furioustank986/huskey60/README.md

# huskey60
Barebones hotswap 60% pcb with USB-C.
KiCad libraries can get messed up depending on what system you're on. Locate the libraries accordingly.
