furioustank986/huskey60/pcb/pcb.kicad_pcb

## KiCad design pcb/pcb.kicad_pcb (2021-10-20)

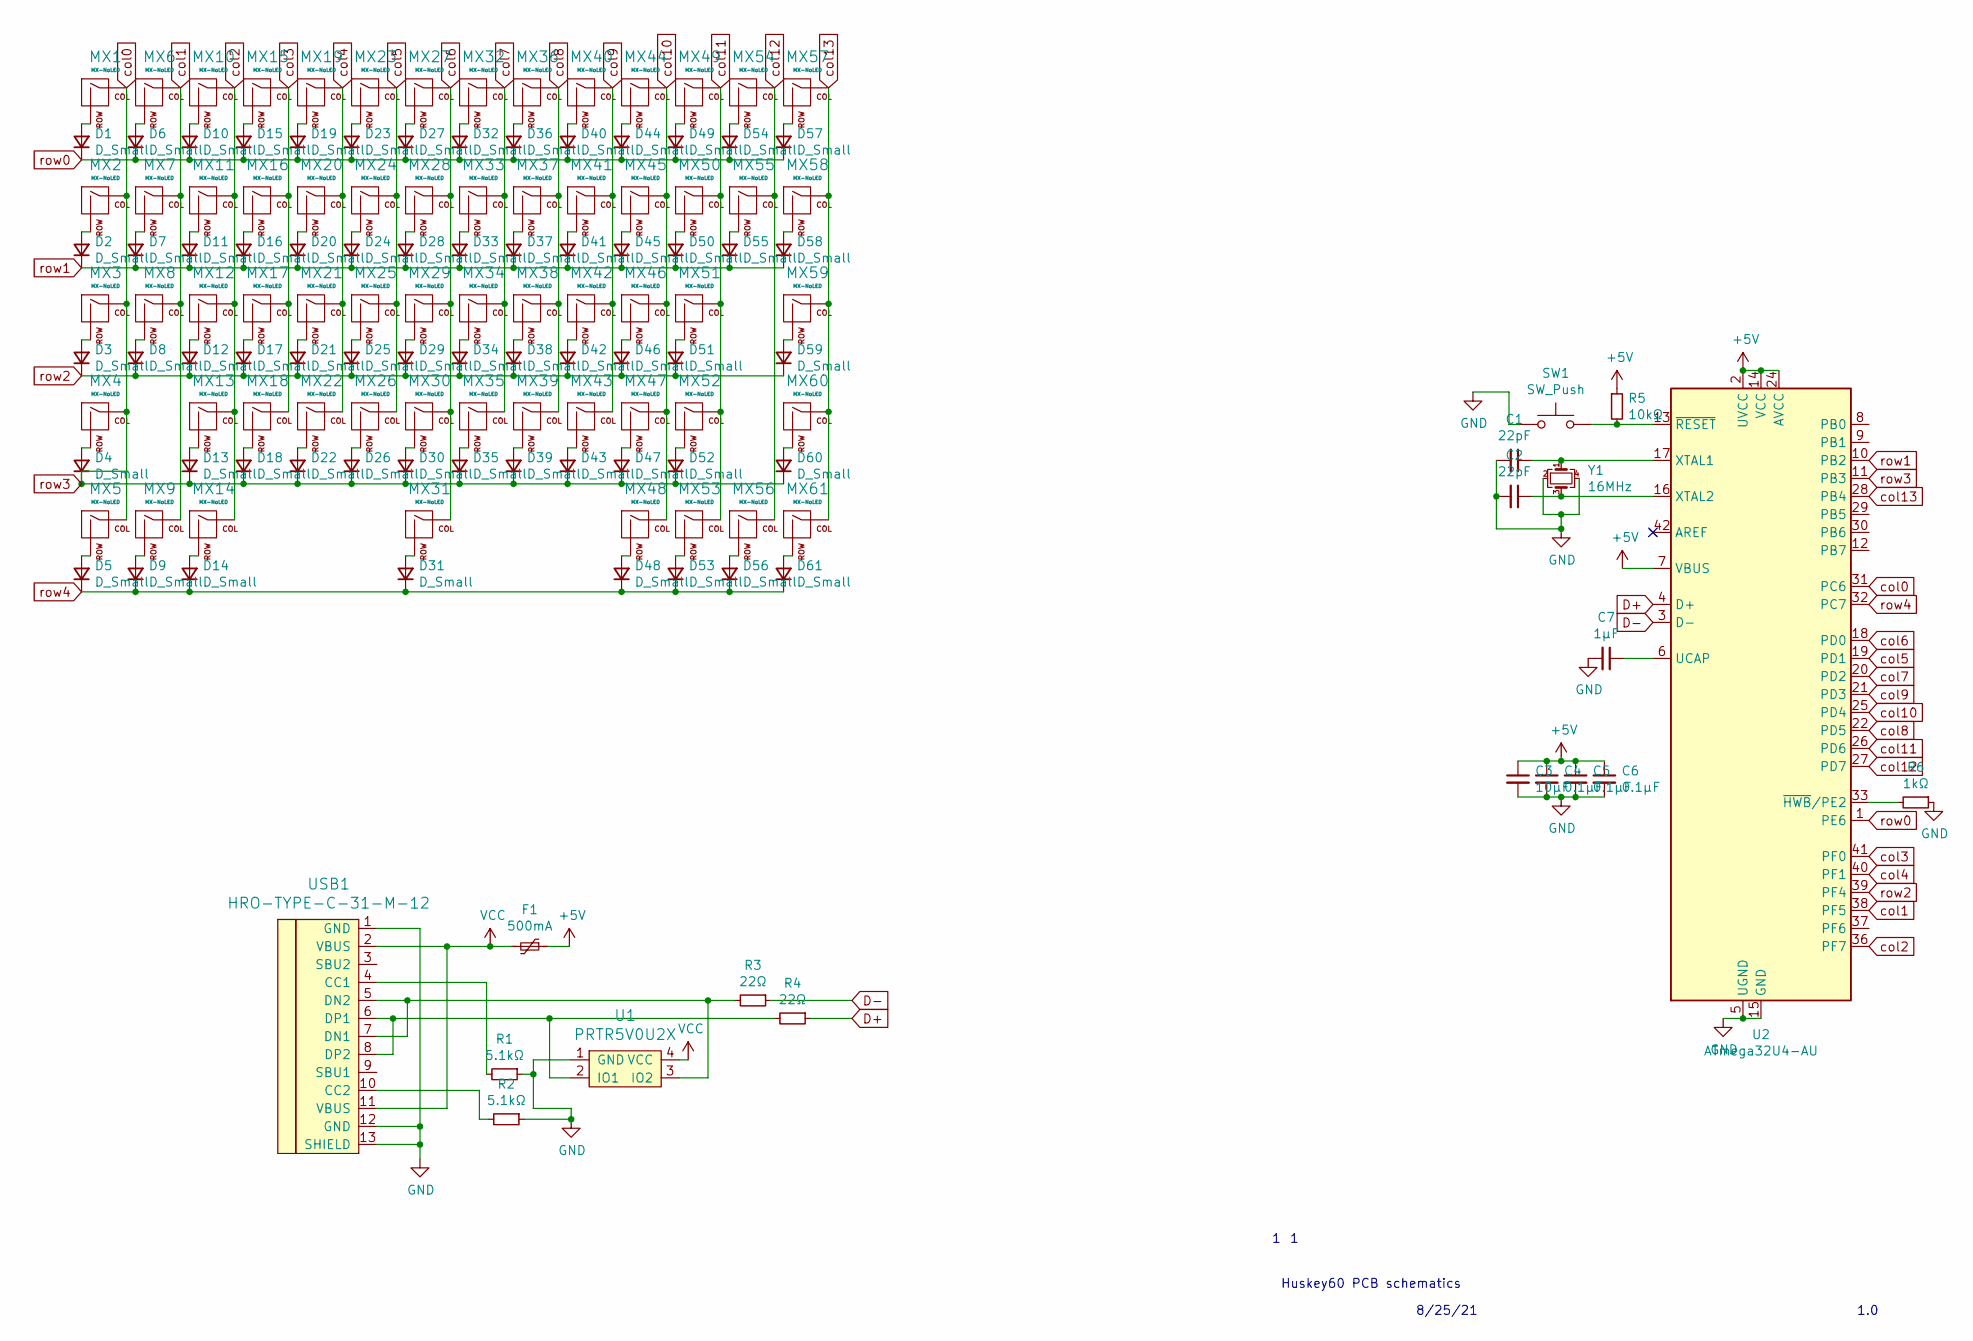
[picture p3: schematic pcb.sch]

Parts:
C1, C2: 22pF; C_0805_2012Metric
C3: 10µF; C_0805_2012Metric
C4, C5, C6: 0.1µF; C_0805_2012Metric
C7: 1µF; C_0805_2012Metric
D1, D2, D3, D4, D5, D6, D7, D8, D9, D10, D11, D12, D13, D14, D15, D16, D17, D18, D19, D20, D21, D22, D23, D24, D25, D26, D27, D28, D29, D30, D31, D32, D33, D34, D35, D36, D37, D38, D39, D40, D41, D42, D43, D44, D45, D46, D47, D48, D49, D50, D51, D52, D53, D54, D55, D56, D57, D58, D59, D60, D61: D_Small; D_SOD-123
F1: 500mA; Fuse_1206_3216Metric
MX1, MX6, MX7, MX8, MX10, MX11, MX12, MX13, MX15, MX16, MX17, MX18, MX19, MX20, MX21, MX22, MX23, MX24, MX25, MX26, MX27, MX28, MX29, MX30, MX32, MX33, MX34, MX35, MX36, MX37, MX38, MX39, MX40, MX41, MX42, MX43, MX44, MX45, MX46, MX47, MX49, MX50, MX51, MX52, MX54, MX55: MX-NoLED; MXOnly-1U-Hotswap
MX2, MX58: MX-NoLED; MXOnly-1.5U-Hotswap
MX3: MX-NoLED; MXOnly-1.75U-Hotswap
MX4, MX59: MX-NoLED; MXOnly-2.25U-Hotswap
MX5, MX9, MX14, MX48, MX53, MX56, MX61: MX-NoLED; MXOnly-1.25U-Hotswap
MX31: MX-NoLED; MXOnly-6.25U-Hotswap
MX57: MX-NoLED; MXOnly-2U-Hotswap
MX60: MX-NoLED; MXOnly-2.75U-Hotswap
R1, R2: 5.1kΩ; R_0805_2012Metric
R3, R4: 22Ω; R_0805_2012Metric
R5: 10kΩ; R_0805_2012Metric
R6: 1kΩ; R_0805_2012Metric
SW1: SW_Push; SKQG-1155865
U1: PRTR5V0U2X; SOT143B
U2: ATmega32U4-AU; TQFP-44_10x10mm_P0.8mm
USB1: HRO-TYPE-C-31-M-12; HRO-TYPE-C-31-M-12-Assembly
Y1: 16MHz; Crystal_SMD_3225-4Pin_3.2x2.5mm

Connections:
+5V: C3.1, C4.1, C5.1, C6.1, F1.1, R5.1, U2.2 (UVCC), U2.7 (VBUS), U2.14 (VCC), U2.24 (AVCC), U2.34 (VCC), U2.44 (AVCC)
D+: R4.1, U2.4 (D+)
D-: R3.1, U2.3 (D-)
GND: C1.2, C2.2, C3.2, C4.2, C5.2, C6.2, C7.2, R1.1, R2.1, R6.1, SW1.1, U1.1 (GND), U2.5 (UGND), U2.15 (GND), U2.23 (GND), U2.35 (GND), U2.43 (GND), USB1.1 (GND), USB1.12 (GND), USB1.13 (SHIELD), Y1.2, Y1.4
unnamed: C1.1, U2.17 (XTAL1), Y1.1
unnamed: C2.1, U2.16 (XTAL2), Y1.3
unnamed: C7.1, U2.6 (UCAP)
unnamed: D1.2 (A), MX1.2 (ROW)
unnamed: D2.2 (A), MX2.2 (ROW)
unnamed: D3.2 (A), MX3.2 (ROW)
unnamed: D4.2 (A), MX4.2 (ROW)
unnamed: D5.2 (A), MX5.2 (ROW)
unnamed: D6.2 (A), MX6.2 (ROW)
unnamed: D7.2 (A), MX7.2 (ROW)
unnamed: D8.2 (A), MX8.2 (ROW)
unnamed: D9.2 (A), MX9.2 (ROW)
unnamed: D10.2 (A), MX10.2 (ROW)
unnamed: D11.2 (A), MX11.2 (ROW)
unnamed: D12.2 (A), MX12.2 (ROW)
unnamed: D13.2 (A), MX13.2 (ROW)
unnamed: D14.2 (A), MX14.2 (ROW)
unnamed: D15.2 (A), MX15.2 (ROW)
unnamed: D16.2 (A), MX16.2 (ROW)
unnamed: D17.2 (A), MX17.2 (ROW)
unnamed: D18.2 (A), MX18.2 (ROW)
unnamed: D19.2 (A), MX19.2 (ROW)
unnamed: D20.2 (A), MX20.2 (ROW)
unnamed: D21.2 (A), MX21.2 (ROW)
unnamed: D22.2 (A), MX22.2 (ROW)
unnamed: D23.2 (A), MX23.2 (ROW)
unnamed: D24.2 (A), MX24.2 (ROW)
unnamed: D25.2 (A), MX25.2 (ROW)
unnamed: D26.2 (A), MX26.2 (ROW)
unnamed: D27.2 (A), MX27.2 (ROW)
unnamed: D28.2 (A), MX28.2 (ROW)
unnamed: D29.2 (A), MX29.2 (ROW)
unnamed: D30.2 (A), MX30.2 (ROW)
unnamed: D31.2 (A), MX31.2 (ROW)
unnamed: D32.2 (A), MX32.2 (ROW)
unnamed: D33.2 (A), MX33.2 (ROW)
unnamed: D34.2 (A), MX34.2 (ROW)
unnamed: D35.2 (A), MX35.2 (ROW)
unnamed: D36.2 (A), MX36.2 (ROW)
unnamed: D37.2 (A), MX37.2 (ROW)
unnamed: D38.2 (A), MX38.2 (ROW)
unnamed: D39.2 (A), MX39.2 (ROW)
unnamed: D40.2 (A), MX40.2 (ROW)
unnamed: D41.2 (A), MX41.2 (ROW)
unnamed: D42.2 (A), MX42.2 (ROW)
unnamed: D43.2 (A), MX43.2 (ROW)
unnamed: D44.2 (A), MX44.2 (ROW)
unnamed: D45.2 (A), MX45.2 (ROW)
unnamed: D46.2 (A), MX46.2 (ROW)
unnamed: D47.2 (A), MX47.2 (ROW)
unnamed: D48.2 (A), MX48.2 (ROW)
unnamed: D49.2 (A), MX49.2 (ROW)
unnamed: D50.2 (A), MX50.2 (ROW)
unnamed: D51.2 (A), MX51.2 (ROW)
unnamed: D52.2 (A), MX52.2 (ROW)
unnamed: D53.2 (A), MX53.2 (ROW)
unnamed: D54.2 (A), MX54.2 (ROW)
unnamed: D55.2 (A), MX55.2 (ROW)
unnamed: D56.2 (A), MX56.2 (ROW)
unnamed: D57.2 (A), MX57.2 (ROW)
unnamed: D58.2 (A), MX58.2 (ROW)
unnamed: D59.2 (A), MX59.2 (ROW)
unnamed: D60.2 (A), MX60.2 (ROW)
unnamed: D61.2 (A), MX61.2 (ROW)
unnamed: R1.2, USB1.4 (CC1)
unnamed: R2.2, USB1.10 (CC2)
unnamed: R3.2, U1.3 (IO2), USB1.5 (DN2), USB1.7 (DN1)
unnamed: R4.2, U1.2 (IO1), USB1.6 (DP1), USB1.8 (DP2)
unnamed: R5.2, SW1.2, U2.13 (~RESET)
unnamed: R6.2, U2.33 (~HWB~/PE2)
VCC: F1.2, U1.4 (VCC), USB1.2 (VBUS), USB1.11 (VBUS)
col0: MX1.1 (COL), MX2.1 (COL), MX3.1 (COL), MX4.1 (COL), MX5.1 (COL), U2.31 (PC6)
col1: MX6.1 (COL), MX7.1 (COL), MX8.1 (COL), MX9.1 (COL), U2.38 (PF5)
col2: MX10.1 (COL), MX11.1 (COL), MX12.1 (COL), MX13.1 (COL), MX14.1 (COL), U2.36 (PF7)
col3: MX15.1 (COL), MX16.1 (COL), MX17.1 (COL), MX18.1 (COL), U2.41 (PF0)
col4: MX19.1 (COL), MX20.1 (COL), MX21.1 (COL), MX22.1 (COL), U2.40 (PF1)
col5: MX23.1 (COL), MX24.1 (COL), MX25.1 (COL), MX26.1 (COL), U2.19 (PD1)
col6: MX27.1 (COL), MX28.1 (COL), MX29.1 (COL), MX30.1 (COL), MX31.1 (COL), U2.18 (PD0)
col7: MX32.1 (COL), MX33.1 (COL), MX34.1 (COL), MX35.1 (COL), U2.20 (PD2)
col8: MX36.1 (COL), MX37.1 (COL), MX38.1 (COL), MX39.1 (COL), U2.22 (PD5)
col9: MX40.1 (COL), MX41.1 (COL), MX42.1 (COL), MX43.1 (COL), U2.21 (PD3)
col10: MX44.1 (COL), MX45.1 (COL), MX46.1 (COL), MX47.1 (COL), MX48.1 (COL), U2.25 (PD4)
col11: MX49.1 (COL), MX50.1 (COL), MX51.1 (COL), MX52.1 (COL), MX53.1 (COL), U2.26 (PD6)
col12: MX54.1 (COL), MX55.1 (COL), MX56.1 (COL), U2.27 (PD7)
col13: MX57.1 (COL), MX58.1 (COL), MX59.1 (COL), MX60.1 (COL), MX61.1 (COL), U2.28 (PB4)
row0: D1.1 (K), D6.1 (K), D10.1 (K), D15.1 (K), D19.1 (K), D23.1 (K), D27.1 (K), D32.1 (K), D36.1 (K), D40.1 (K), D44.1 (K), D49.1 (K), D54.1 (K), D57.1 (K), U2.1 (PE6)
row1: D2.1 (K), D7.1 (K), D11.1 (K), D16.1 (K), D20.1 (K), D24.1 (K), D28.1 (K), D33.1 (K), D37.1 (K), D41.1 (K), D45.1 (K), D50.1 (K), D55.1 (K), D58.1 (K), U2.10 (PB2)
row2: D3.1 (K), D8.1 (K), D12.1 (K), D17.1 (K), D21.1 (K), D25.1 (K), D29.1 (K), D34.1 (K), D38.1 (K), D42.1 (K), D46.1 (K), D51.1 (K), D59.1 (K), U2.39 (PF4)
row3: D4.1 (K), D13.1 (K), D18.1 (K), D22.1 (K), D26.1 (K), D30.1 (K), D35.1 (K), D39.1 (K), D43.1 (K), D47.1 (K), D52.1 (K), D60.1 (K), U2.11 (PB3)
row4: D5.1 (K), D9.1 (K), D14.1 (K), D31.1 (K), D48.1 (K), D53.1 (K), D56.1 (K), D61.1 (K), U2.32 (PC7)

Notes on the sheet:
Huskey60 PCB schematics
8/25/21
1.0

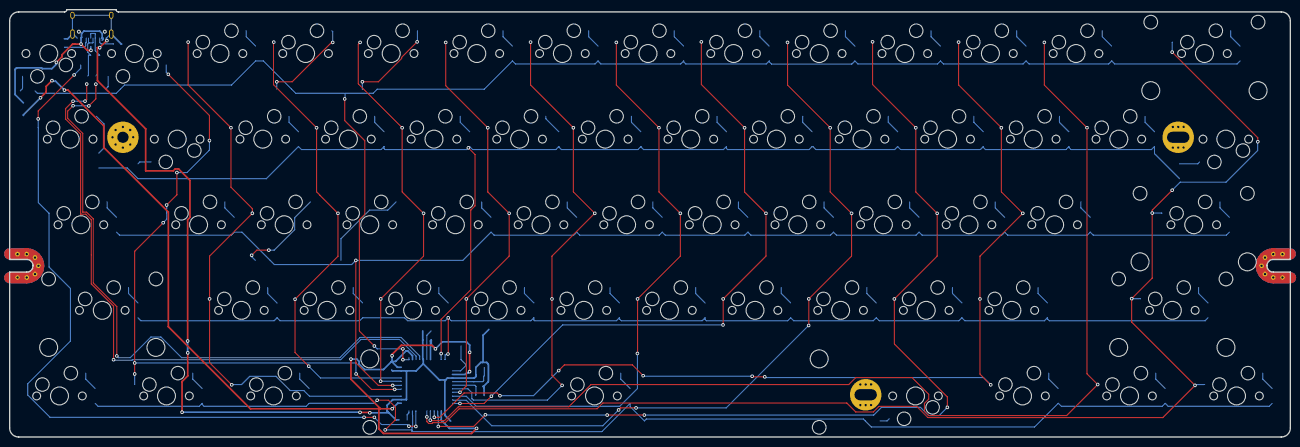
[picture p4: board pcb.kicad_pcb from above]

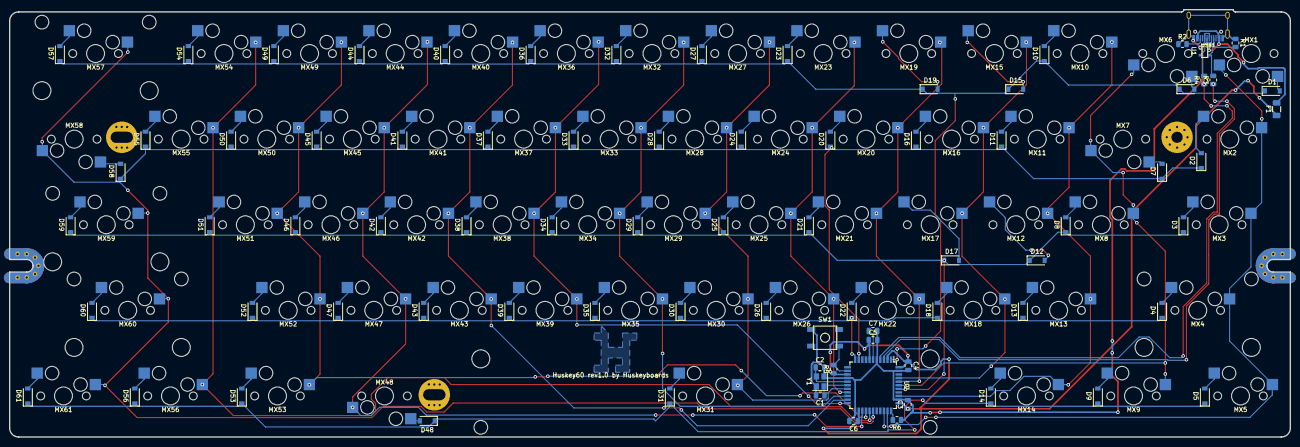
[picture p5: board pcb.kicad_pcb from below]

Board: 2 copper layers, 285.0 x 95.1 mm, 141 parts (80 on the bottom side), 94 nets.
