furioustank986/huskey60/(commit log)

2021-05-29 Added pcb files
    [pcb.kicad_pcb, pcb.sch]
2021-05-30 pcb WIP
    [pcb.kicad_pcb]
2021-06-12 finished rev 1 PCB
    [pcb.kicad_pcb, pcb.sch]
2021-08-15 added locallib
    [pcb-B_Adhes.gbr, pcb-B_CrtYd.gbr, pcb-B_Cu.gbr, pcb-B_Fab.gbr, pcb-B_Mask.gbr, pcb-B_Paste.gbr, pcb-B_SilkS.gbr, pcb-Cmts_User.gbr]
2021-08-23 whatever update was done
    [pcb.sch]
2021-08-23 flipped spacebar stabs
    [pcb.kicad_pcb]
2021-08-25 added new gerber files and updated pcb
    [pcb-B_Adhes.gbr, pcb-B_CrtYd.gbr, pcb-B_Cu.gbr, pcb-B_Fab.gbr, pcb-B_Mask.gbr, pcb-B_Paste.gbr, pcb-B_SilkS.gbr, pcb-Cmts_User.gbr]
2021-10-20 added gerber
    [pcb.kicad_pcb, pcb.sch]
